KisonHe/KisonPill/README.md

# KisonPill

Use the switch at the bottom to choose serial download from cp2102 on board or ft2232.
R1 should be left not connected.
