KisonHe/KisonPill/KisonPill.kicad_pcb

## KiCad design KisonPill.kicad_pcb (2023-06-13)

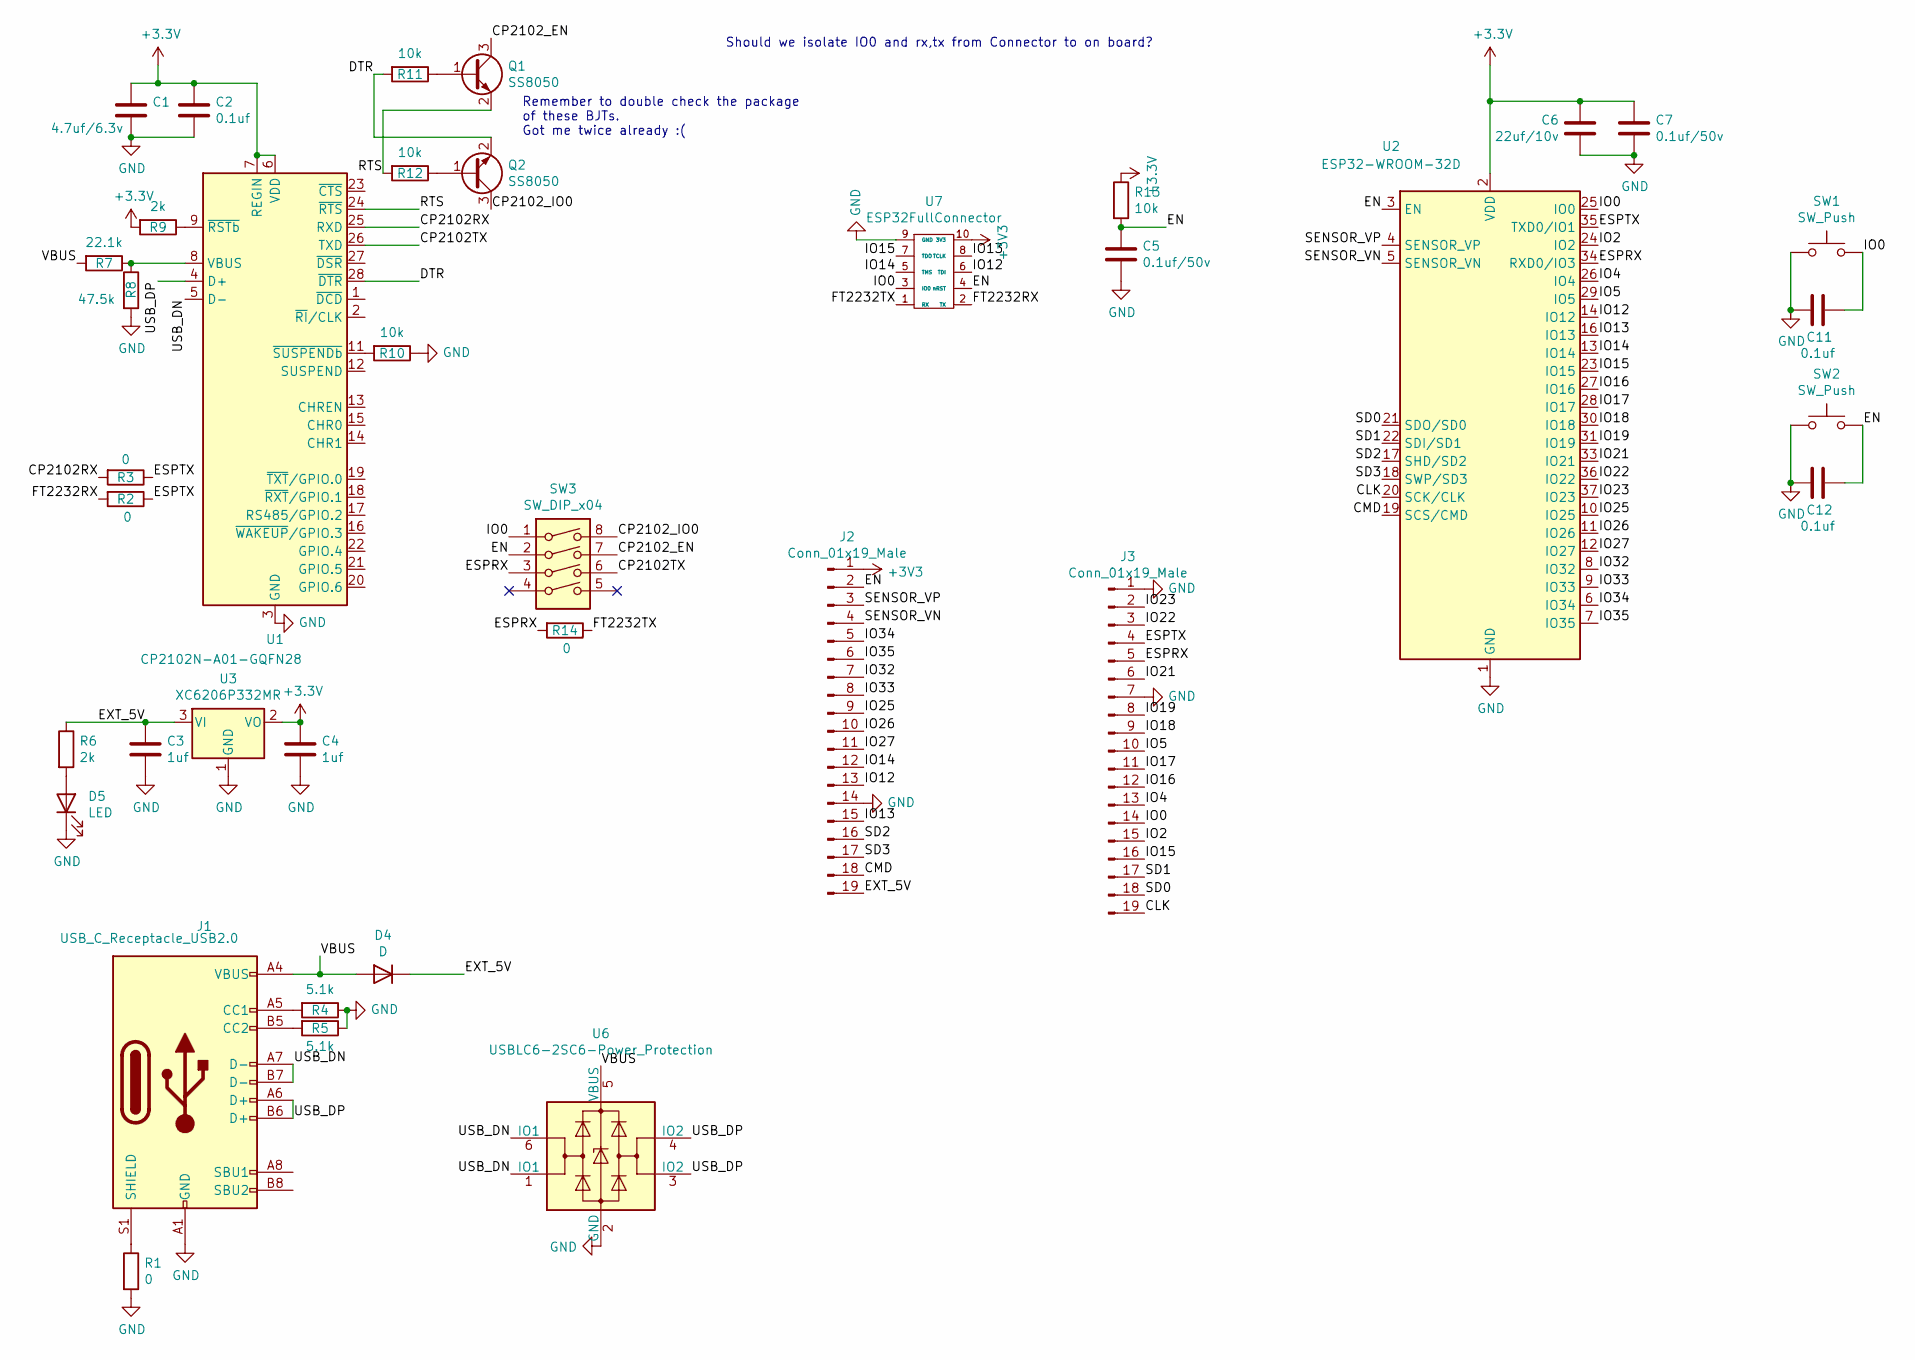
[picture p1: schematic KisonPill.sch]

Parts:
C1: 4.7uf/6.3v; C_0603_1608Metric; LCSC C907730
C2, C11, C12: 0.1uf; C_0603_1608Metric; LCSC C1688
C3, C4: 1uf; C_0603_1608Metric
C5, C7: 0.1uf/50v; C_0603_1608Metric; LCSC C1688
C6: 22uf/10v; C_1206_3216Metric; LCSC C319197
D4: D; D_SOD-323; LCSC C124187
D5: LED; LED_0603_1608Metric; LCSC C181863
J1: USB_C_Receptacle_USB2.0; USB_C_Receptacle_HRO_TYPE-C-31-M-12; LCSC C165948
J2, J3: Conn_01x19_Male; PinHeader_1x19_P2.54mm_Vertical
Q1, Q2: SS8050; SOT-23; LCSC C541705
R1, R2, R3, R14: 0; R_0603_1608Metric; LCSC C429667
R4, R5: 5.1k; R_0603_1608Metric; LCSC C325524
R6, R9: 2k; R_0603_1608Metric; LCSC C226705
R7: 22.1k; R_0603_1608Metric; LCSC C325588
R8: 47.5k; R_0603_1608Metric; LCSC C25896
R10, R11, R12, R13: 10k; R_0603_1608Metric; LCSC C149898
SW1, SW2: SW_Push; BTN-TS342A4P-WZ-C557592; LCSC C557592
SW3: SW_DIP_x04; SW_DIP_SPSTx04_Slide_Copal_CHS-04B_W7.62mm_P1.27mm
U1: CP2102N-A01-GQFN28; QFN-28-1EP_5x5mm_P0.5mm_EP3.35x3.35mm
U2: ESP32-WROOM-32D; ESP32-WROOM-32
U3: XC6206P332MR; SOT-23
U6: USBLC6-2SC6-Power_Protection; USBLC6-2P6-SOT666
U7: ESP32FullConnector; Molex_CLIK-Mate_502382-1070_1x10-1MP_P1.25mm_Vertical

Connections:
/CLK: J3.19, U2.20 (SCK/CLK)
/CMD: J2.18, U2.19 (SCS/CMD)
/CP2102RX: R3.2, U1.25 (RXD)
/CP2102TX: SW3.6, U1.26 (TXD)
/CP2102_EN: Q1.3 (C), SW3.7
/CP2102_IO0: Q2.3 (C), SW3.8
/DTR: Q2.2 (E), R11.2, U1.28 (~DTR)
/EN: C5.1, C12.2, J2.2, R13.2, SW2.2, SW3.2, U2.3 (EN), U7.4 (nRST)
/ESPRX: J3.5, R14.2, SW3.3, U2.34 (RXD0/IO3)
/ESPTX: J3.4, R2.1, R3.1, U2.35 (TXD0/IO1)
/EXT_5V: C3.1, D4.1 (K), J2.19, R6.1, U3.3 (VI)
/FT2232RX: R2.2, U7.2 (TX)
/FT2232TX: R14.1, U7.1 (RX)
/IO0: C11.2, J3.14, SW1.2, SW3.1, U2.25 (IO0), U7.3 (IO0)
/IO2: J3.15, U2.24 (IO2)
/IO4: J3.13, U2.26 (IO4)
/IO5: J3.10, U2.29 (IO5)
/IO12: J2.13, U2.14 (IO12), U7.6 (TDI)
/IO13: J2.15, U2.16 (IO13), U7.8 (TCLK)
/IO14: J2.12, U2.13 (IO14), U7.5 (TMS)
/IO15: J3.16, U2.23 (IO15), U7.7 (TDO)
/IO16: J3.12, U2.27 (IO16)
/IO17: J3.11, U2.28 (IO17)
/IO18: J3.9, U2.30 (IO18)
/IO19: J3.8, U2.31 (IO19)
/IO21: J3.6, U2.33 (IO21)
/IO22: J3.3, U2.36 (IO22)
/IO23: J3.2, U2.37 (IO23)
/IO25: J2.9, U2.10 (IO25)
/IO26: J2.10, U2.11 (IO26)
/IO27: J2.11, U2.12 (IO27)
/IO32: J2.7, U2.8 (IO32)
/IO33: J2.8, U2.9 (IO33)
/IO34: J2.5, U2.6 (IO34)
/IO35: J2.6, U2.7 (IO35)
/RTS: Q1.2 (E), R12.2, U1.24 (~RTS)
/SD0: J3.18, U2.21 (SDO/SD0)
/SD1: J3.17, U2.22 (SDI/SD1)
/SD2: J2.16, U2.17 (SHD/SD2)
/SD3: J2.17, U2.18 (SWP/SD3)
/SENSOR_VN: J2.4, U2.5 (SENSOR_VN)
/SENSOR_VP: J2.3, U2.4 (SENSOR_VP)
/USB_DN: J1.A7 (D-), J1.B7 (D-), U1.5 (D-), U6.1 (IO1), U6.6 (IO1)
/USB_DP: J1.A6 (D+), J1.B6 (D+), U1.4 (D+), U6.3 (IO2), U6.4 (IO2)
/VBUS: D4.2 (A), J1.A4 (VBUS), J1.A9 (VBUS), J1.B4 (VBUS), J1.B9 (VBUS), R7.2, U6.5 (VBUS)
GND: C1.2, C2.2, C3.2, C4.2, C5.2, C6.1, C7.2, C11.1, C12.1, D5.1 (K), J1.A1 (GND), J1.A12 (GND), J1.B1 (GND), J1.B12 (GND), J2.14, J3.1, J3.7, R1.2, R4.1, R5.1, R8.2, R10.1, SW1.1, SW2.1, U1.3 (GND), U1.29 (GND), U2.1 (GND), U2.15 (GND), U2.38 (GND), U2.39 (GND), U3.1 (GND), U6.2 (GND), U7.9 (GND)
unnamed: D5.2 (A), R6.2
unnamed: J1.A5 (CC1), R4.2
unnamed: J1.B5 (CC2), R5.2
unnamed: J1.S1 (SHIELD), R1.1
unnamed: Q1.1 (B), R11.1
unnamed: Q2.1 (B), R12.1
unnamed: R7.1, R8.1, U1.8 (VBUS)
unnamed: R9.1, U1.9 (~RSTb)
unnamed: R10.2, U1.11 (~SUSPENDb)

Notes on the sheet:
Should we isolate IO0 and rx,tx from Connector to on board?
Remember to double check the package of these BJTs. Got me twice already :(

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
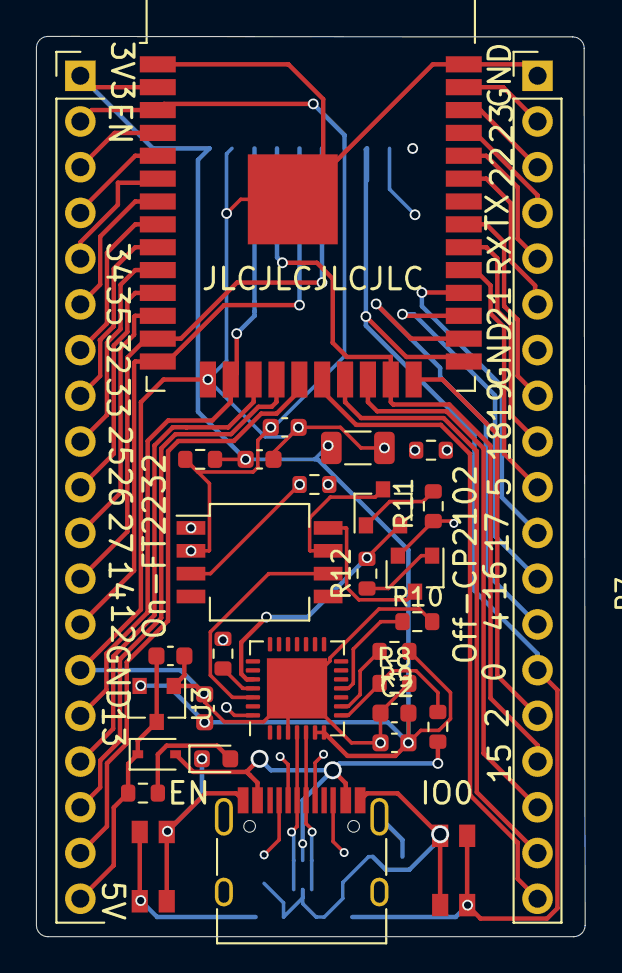
[picture p2: board KisonPill.kicad_pcb from above]

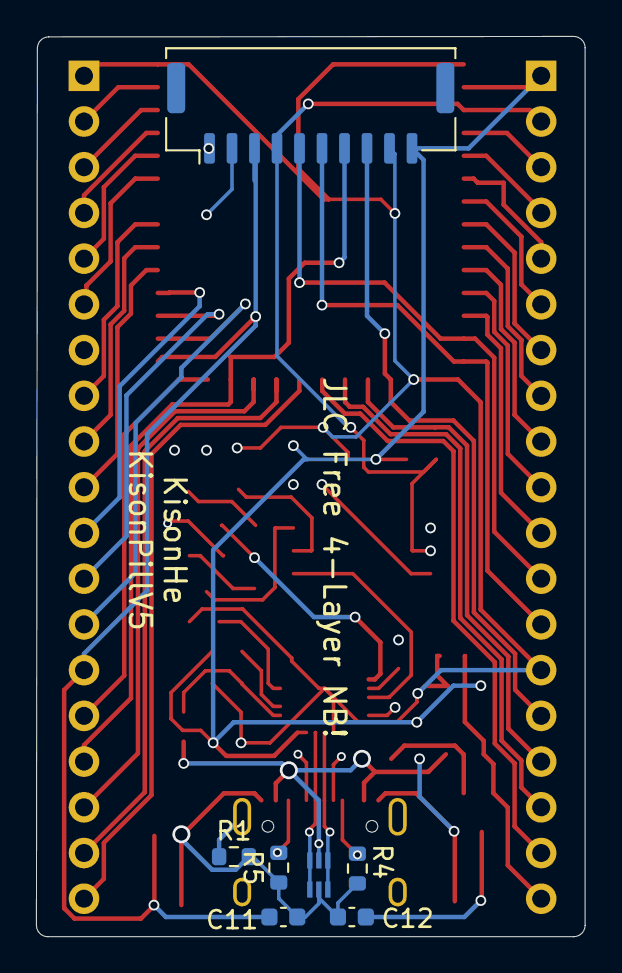
[picture p3: board KisonPill.kicad_pcb from below]

Board: 4 copper layers, 30.5 x 50.0 mm, 38 parts (7 on the bottom side), 56 nets.
