KisonHe/KisonPill/(commit log)

2021-03-17 Add Elaina
    [KisonPill.kicad_pcb]
2021-04-06 Fix Error Over RX&TX
    [KisonPill.kicad_pcb, KisonPill.sch]
2021-04-07 Error Fix
    [KisonPill.sch]
2021-04-12 Improve Texts
    [KisonPill.kicad_pcb]
2021-04-21 Added a switch to pick TX
    [KisonPill.kicad_pcb, KisonPill.sch]
2021-04-22 Fix Direction Errors
    [KisonPill.kicad_pcb]
2021-04-29 Modify Button
    [KisonPill.kicad_pcb, KisonPill.sch]
2021-06-29 V5
    Fix BJT package bug :(
    [KisonPill.kicad_pcb, KisonPill.sch]
